Pyrina/dice/eagle/dice-2.brd

## EAGLE design eagle/dice-2.brd (2015-04-01)

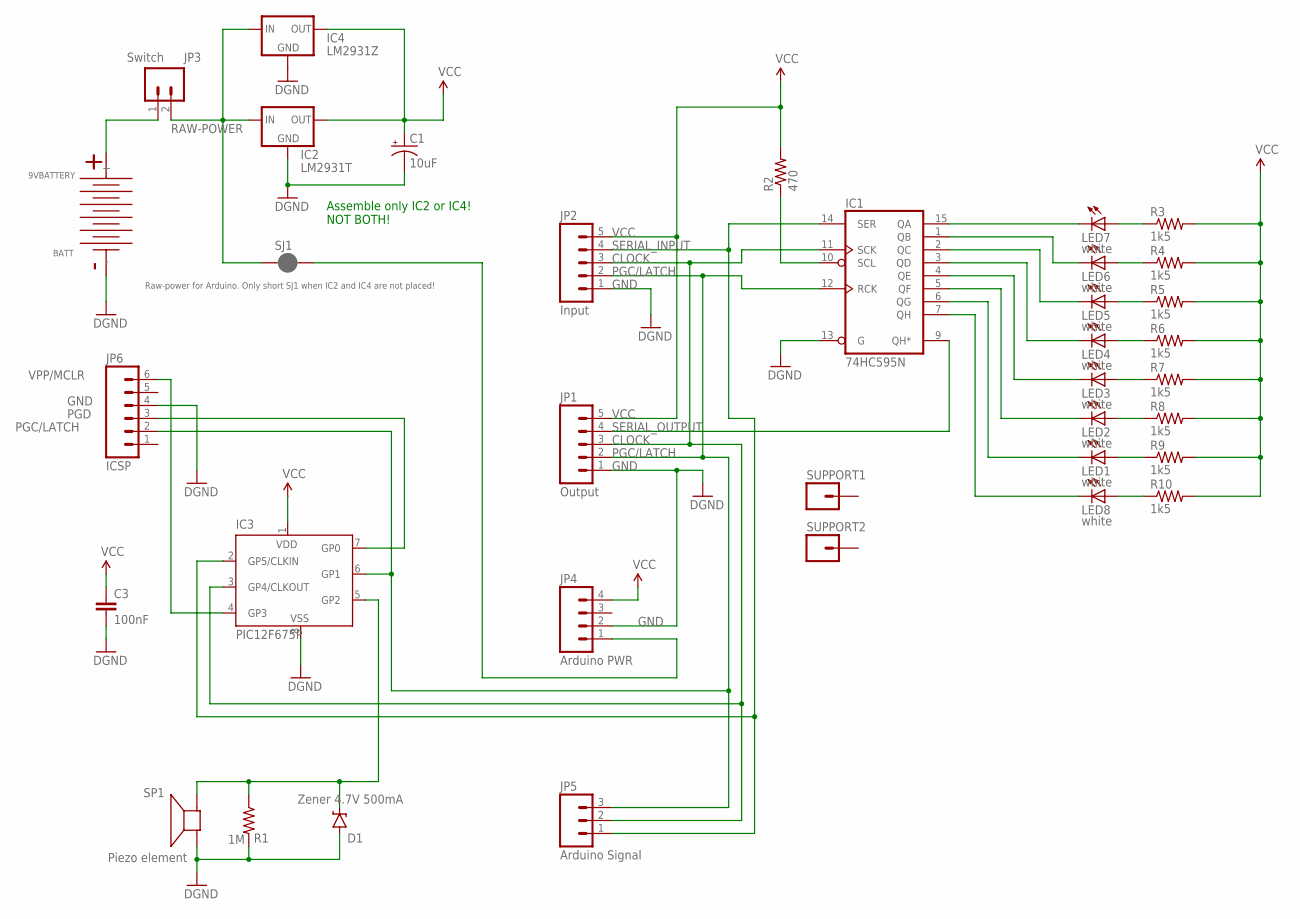
[picture p1: schematic dice-2.sch]

Parts:
BATT: 9VBATTERY; 9V-BATTERY-HOLDER
C1: 10uF; CPOL-RADIAL-10UF-25V
C3: 100nF; CAP-PTH-5MM
D1: Zener 4.7V 500mA; DIODE-ZENER
IC1: 74HC595N; DIL16
IC2: LM2931T; TO220S
IC3: PIC12F675P; DIL8
IC4: LM2931Z; TO92
JP1: Output; 1X05
JP2: Input; 1X05
JP3: Switch; 1X02
JP4: Arduino PWR; 1X04
JP5: Arduino Signal; 1X03
JP6: ICSP; 1X06-SIP_LOCK
LED1, LED2, LED3, LED4, LED5, LED6, LED7, LED8: white; LED5MM
R1: 1M; AXIAL-0.4
R2: 470; AXIAL-0.4
R3, R4, R5, R6, R7, R8, R9, R10: 1k5; AXIAL-0.4
SJ1: Raw-power for Arduino. Only short SJ1 when IC2 an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; PAD-JUMPER-2-NC_BY_PASTE_YES_SILK
SP1: Piezo element; PS12
SUPPORT1, SUPPORT2: M01PTH; 1X01

Connections:
CLOCK: IC1.11 (SCK), IC3.3 (GP4/CLKOUT), JP1.3, JP2.3, JP5.2
GND: BATT.-, C1.2 (-), C3.2, D1.P$2 (A), IC1.8 (GND), IC1.13 (G), IC2.2 (GND), IC3.8 (VSS), IC4.2 (GND), JP1.1, JP2.1, JP4.2, JP6.4, R1.P$2 (2), SP1.P$1 (+)
unnamed: IC1.15 (QA), LED7.K (C)
unnamed: IC1.1 (QB), LED6.K (C)
unnamed: IC1.5 (QF), LED2.K (C)
unnamed: IC1.2 (QC), LED5.K (C)
unnamed: IC1.3 (QD), LED4.K (C)
unnamed: IC1.4 (QE), LED3.K (C)
unnamed: LED6.A, R4.P$1 (1)
unnamed: IC1.6 (QG), LED1.K (C)
unnamed: LED7.A, R3.P$1 (1)
unnamed: LED5.A, R5.P$1 (1)
unnamed: LED4.A, R6.P$1 (1)
unnamed: LED3.A, R7.P$1 (1)
unnamed: LED1.A, R9.P$1 (1)
unnamed: BATT.+, JP3.1
unnamed: IC1.7 (QH), LED8.K (C)
unnamed: LED8.A, R10.P$1 (1)
unnamed: IC1.10 (SCL), R2.P$1 (1)
unnamed: D1.P$1 (C), IC3.5 (GP2), R1.P$1 (1), SP1.P$2 (-)
unnamed: JP4.1, SJ1.2
unnamed: LED2.A, R8.P$1 (1)
PGC/LATCH: IC1.12 (RCK), IC3.6 (GP1), JP1.2, JP2.2, JP5.3, JP6.2
PGD: IC3.7 (GP0), JP6.3
RAW-POWER: IC2.1 (IN), IC4.3 (IN), JP3.2, SJ1.1
SERIAL_INPUT: IC1.14 (SER), IC3.2 (GP5/CLKIN), JP2.4, JP5.1
SERIAL_OUTPUT: IC1.9 (QH*), JP1.4
VCC: C1.1 (+), C3.1, IC1.16 (VCC), IC2.3 (OUT), IC3.1 (VDD), IC4.1 (OUT), JP1.5, JP2.5, JP4.4, R2.P$2 (2), R3.P$2 (2), R4.P$2 (2), R5.P$2 (2), R6.P$2 (2), R7.P$2 (2), R8.P$2 (2), R9.P$2 (2), R10.P$2 (2)
VPP/MCLR: IC3.4 (GP3), JP6.6

Notes on the sheet:
Assemble only IC2 or IC4! NOT BOTH!

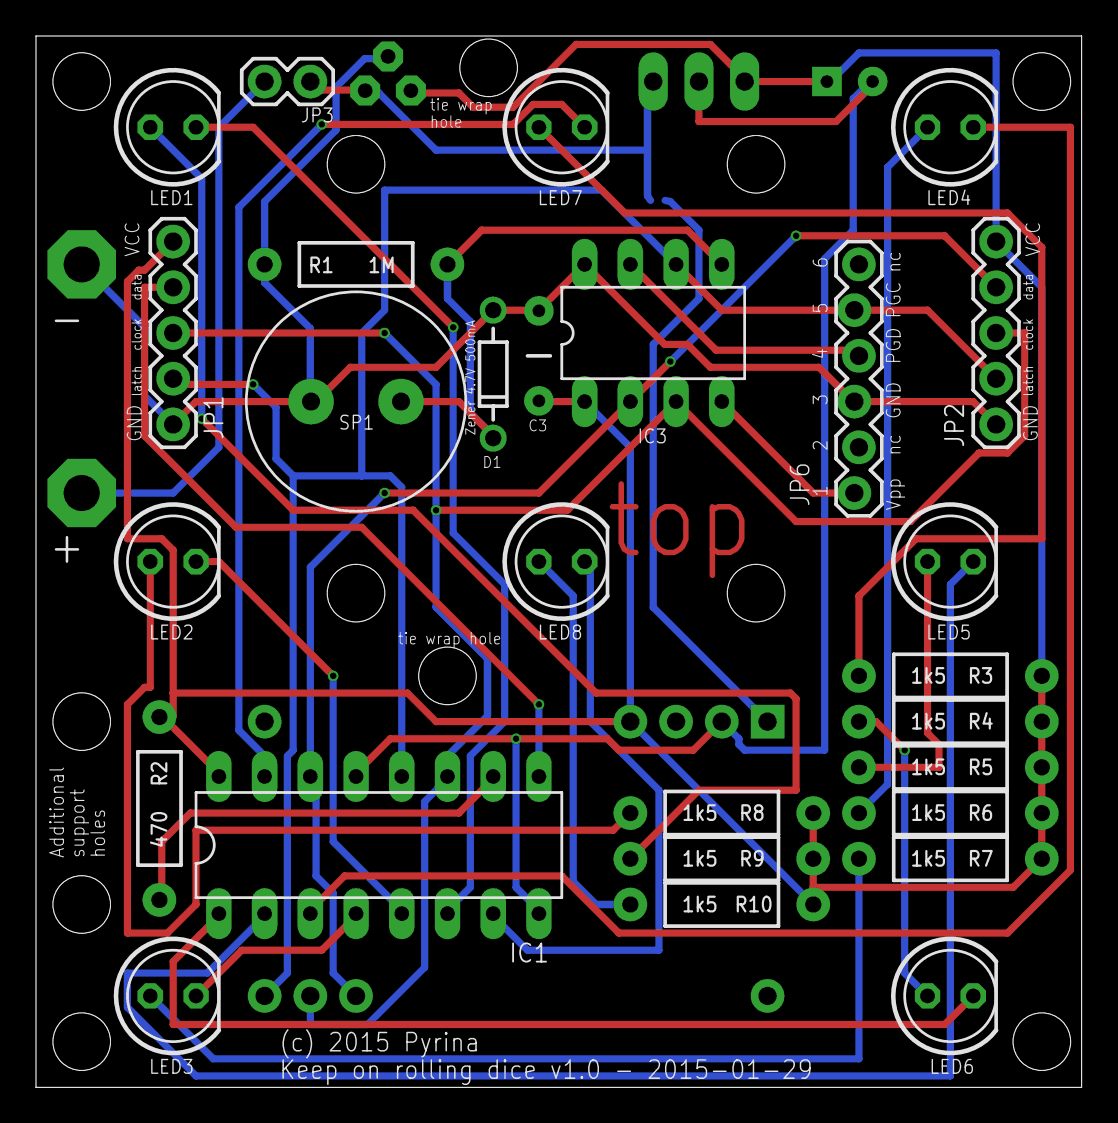
[picture p2: board dice-2.brd from above]

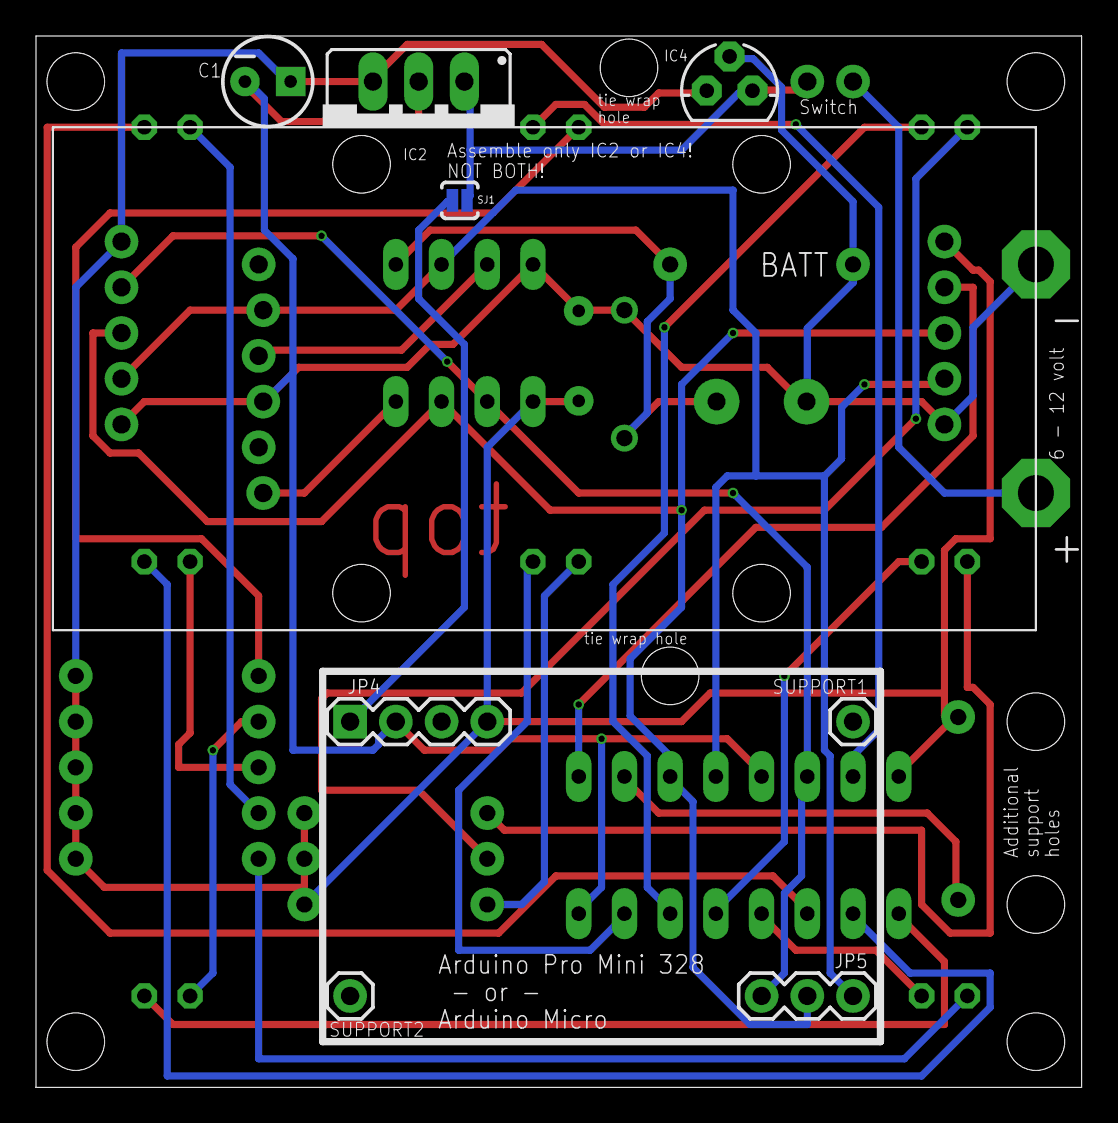
[picture p3: board dice-2.brd from below]

Board: 2 copper layers, 58.1 x 58.4 mm, 36 parts (9 on the bottom side), 29 nets.
