Pyrina/dice/(notices)

Notices in the files:
eagle/dice-2.brd:
(c) 2015 Pyrina
parts and their libraries:
SparkFun-Aesthetics: Licensing: Creative Commons ShareAlike 4.0 International - https://creativecommons.org/licenses/by-sa/4.0
